selfproclaimengineer/legacy-2026/program lama/hexapod_robot_legacy/README.md

# program_hexapod_robot_legacy
Trajectory program, inverse kinematics, and body kinematics were developed in December 2023.

1. The leg program is a developmental program to move the robot.
2. The leg_trajectory_new program is a third-order trajectory program still in the development stage. For the future, the developed leg program will be the leg.ino program.
