selfproclaimengineer/legacy-2026/program lama/code_legacy_2024/CODE_LEGACY_2024/README.md

Mulai di upload tanggal 28 oktober 2024

=====28 Oktober=====
1. Robot sudah sampai bawah tangga
2. coxa femur tibia butuh di adjuts(sudah)
3. tinggi langkah sudah ok

======29 Oktober======
1. Bisa bawah tangga namun masih kadang error, butuh proteksi tambahan
2. settingan terbaru kaki bisa mulus lantai pecah , tapi masih bisa ditingkatkan
3. servo rusak saatnya pulang
