selfproclaimengineer/legacy-2026/program lama/hexapod_robot_legacy/master/readme

setup arduino
setup board
