selfproclaimengineer/legacy-2026/HEXAPOD_KRSRI_2026/config.h

#ifndef CONFIG_H
#define CONFIG_H

// =====================================================================
//  KONFIGURASI PUSAT HEXAPOD KRSRI 2026
//  Semua "knob" kalibrasi ada di sini. Ubah angka, JANGAN ubah logika.
//  Konvensi sumbu (body frame):
//     +X = kanan, +Y = depan, +Z = atas. Origin = pusat badan.
//  File ini murni konstanta (stdint saja) -> aman di-include host & Teensy.
// =====================================================================
#include <stdint.h>

#define NUM_SERVOS 18   // 6 kaki x 3 sendi (lengan terpisah, lihat ARM_*)

// ---------------------------------------------------------------------
//  DIMENSI KAKI (mm) -- ukur fisik robot Anda
// ---------------------------------------------------------------------
#define COXA_LENGTH   20.0f
#define FEMUR_LENGTH  80.0f
#define TIBIA_LENGTH  90.0f

// ---------------------------------------------------------------------
//  GEOMETRI BADAN
//  BODY_LEG_ORIGINS = posisi pangkal coxa tiap kaki relatif pusat (mm).
//  BODY_LEG_ANGLE   = arah hadap kaki (derajat, dari +X, CCW positif).
//                     Dipakai untuk transform titik kaki -> frame kaki
//                     supaya IK benar walau kaki terpasang menyudut.
//  Urutan kaki: 0=Ka-Depan 1=Ka-Tengah 2=Ka-Belakang
//               3=Ki-Belakang 4=Ki-Tengah 5=Ki-Depan
// ---------------------------------------------------------------------
const float BODY_LEG_ORIGINS[6][3] = {
    { 45.0f,  78.0f, 0.0f},  // 0
    { 90.0f,   0.0f, 0.0f},  // 1
    { 45.0f, -78.0f, 0.0f},  // 2
    {-45.0f, -78.0f, 0.0f},  // 3
    {-90.0f,   0.0f, 0.0f},  // 4
    {-45.0f,  78.0f, 0.0f}   // 5
};
const float BODY_LEG_ANGLE[6] = {
     60.0f,    // 0 Ka-Depan
      0.0f,    // 1 Ka-Tengah
    -60.0f,    // 2 Ka-Belakang
   -120.0f,    // 3 Ki-Belakang
    180.0f,    // 4 Ki-Tengah
    120.0f     // 5 Ki-Depan
};

// ---------------------------------------------------------------------
//  POSISI BERDIRI (HOME) ujung kaki, di frame badan (mm)
//  STAND_HEIGHT positif = tinggi badan dari tanah; foot z = -STAND_HEIGHT.
//  STAND_RADIUS = seberapa jauh kaki melebar dari origin coxa.
// ---------------------------------------------------------------------
#define STAND_HEIGHT  100.0f
#define STAND_RADIUS   70.0f   // jarak ujung kaki ke pangkal coxa (arah hadap kaki)

// ---------------------------------------------------------------------
//  PETA PIN SERVO KAKI  {driver_index(0/1), channel(0..15)}
//  driver 0 = PCA9685 @0x40, driver 1 = @0x41
// ---------------------------------------------------------------------
const uint8_t SERVO_PIN_MAP[NUM_SERVOS][2] = {
    {0, 8},  {0, 9},  {0, 10}, // Kaki 0 (coxa,femur,tibia)
    {0, 4},  {0, 5},  {0, 6},  // Kaki 1
    {0, 0},  {0, 1},  {0, 2},  // Kaki 2
    {1, 8},  {1, 9},  {1, 10}, // Kaki 3
    {1, 4},  {1, 5},  {1, 6},  // Kaki 4
    {1, 0},  {1, 1},  {1, 2}   // Kaki 5
};

// ---------------------------------------------------------------------
//  KALIBRASI SERVO
//  SERVO_PULSE_MIN/MAX = pulse (us) untuk 0 dan 180 derajat servo.
//  SERVO_INVERT  = balik arah putaran sendi.
//  SERVO_OFFSET  = derajat offset agar pose HOME = mekanik netral.
//                  ATUR per-servo saat kalibrasi (lihat README bag. Kalibrasi).
//  SERVO_TRIM_US = trim halus dalam mikrodetik (koreksi gear backlash).
// ---------------------------------------------------------------------
#define SERVO_PULSE_MIN  500
#define SERVO_PULSE_MAX  2500

const bool SERVO_INVERT[NUM_SERVOS] = {
    false, false, false,  // Kaki 0
    false, false, false,  // Kaki 1
    false, false, false,  // Kaki 2
    true,  true,  true,   // Kaki 3 (sisi kiri biasanya terbalik)
    true,  true,  true,   // Kaki 4
    true,  true,  true    // Kaki 5
};
const float SERVO_OFFSET[NUM_SERVOS] = {
    0,0,0,  0,0,0,  0,0,0,   // kanan
    0,0,0,  0,0,0,  0,0,0    // kiri  (isi saat kalibrasi)
};
const int16_t SERVO_TRIM_US[NUM_SERVOS] = {
    0,0,0,  0,0,0,  0,0,0,
    0,0,0,  0,0,0,  0,0,0
};

// ---------------------------------------------------------------------
//  GAIT (default = jalan datar). Profil medan diatur runtime via setProfile.
// ---------------------------------------------------------------------
#define GAIT_STEP_HEIGHT  40.0f    // mm, tinggi angkat kaki
#define GAIT_STEP_LENGTH  60.0f    // mm, panjang langkah penuh
#define GAIT_CYCLE_TIME   900.0f   // ms, 1 siklus penuh
#define GAIT_DUTY         0.5f     // fraksi waktu kaki menapak (tripod=0.5)

// ---------------------------------------------------------------------
//  LENGAN / GRIPPER (untuk ambil korban)
//  Default 3 servo pada driver 0 channel 12,13,14: base, shoulder, gripper.
//  Pose dalam derajat 0..180 (sudut servo). KALIBRASI sesuai mekanik.
// ---------------------------------------------------------------------
#define ARM_NUM_SERVOS 3
// Dua lengan: kanan di driver 0, kiri di driver 1 (base, shoulder, gripper).
const uint8_t ARM_PIN_MAP_R[ARM_NUM_SERVOS][2] = { {0, 12}, {0, 13}, {0, 14} };
const uint8_t ARM_PIN_MAP_L[ARM_NUM_SERVOS][2] = { {1, 12}, {1, 13}, {1, 14} };
// Pose: {base, shoulder, gripper}
const float ARM_POSE_PARK[ARM_NUM_SERVOS]  = { 90,  30,  20 };  // lipat aman
const float ARM_POSE_REACH[ARM_NUM_SERVOS] = { 90, 150,  70 };  // julur, capit buka
const float ARM_POSE_GRIP[ARM_NUM_SERVOS]  = { 90, 150,  10 };  // capit tutup
const float ARM_POSE_LIFT[ARM_NUM_SERVOS]  = { 90,  60,  10 };  // angkat korban
const float ARM_POSE_DROP[ARM_NUM_SERVOS]  = { 90, 120,  70 };  // taruh di safe zone

// ---------------------------------------------------------------------
//  BUS I2C — SATU jalur (sesuai PCB: 1x SDA/SCL untuk semua device).
//  Semua di Wire (SDA 18 / SCL 19 Teensy 4.1): 2x PCA9685 + mux + 6 VL53L1X.
//  Clock dibatasi 400 kHz karena VL53L1X & TCA9548A maksimum Fast Mode (400k);
//  walau PCA9685 bisa 1 MHz, di bus bersama clock ikut device terlambat.
//  (Pisah ke Wire1 untuk servo @1MHz HANYA bila PCB di-rework — lihat README.)
// ---------------------------------------------------------------------
#define SERVO_I2C_BUS    Wire
#define SERVO_I2C_CLOCK  400000
#define LIDAR_I2C_BUS    Wire
#define LIDAR_I2C_CLOCK  400000

// ---------------------------------------------------------------------
//  SENSOR
// ---------------------------------------------------------------------
#define NUM_LIDAR        6
#define I2C_MUX_ADDR     0x70
// Indeks lidar -> arti (sesuaikan pemasangan fisik)
#define LIDAR_FRONT      0
#define LIDAR_FRONT_R    1
#define LIDAR_RIGHT      2
#define LIDAR_BACK       3
#define LIDAR_LEFT       4
#define LIDAR_FRONT_L    5

#define IMU_SERIAL       Serial1
#define IMU_BAUD         921600   // Yahboom 10-axis (protokol WIT, frame 0x55)

// ---------------------------------------------------------------------
//  NAVIGASI (closed-loop)
// ---------------------------------------------------------------------
#define HEADING_KP        0.020f   // gain belok per derajat error heading
#define HEADING_TOL_DEG   3.0f     // toleransi heading dianggap "lurus"
#define WALL_SETPOINT_CM  13       // jarak target ke dinding (cm)
#define WALL_KP           0.030f   // gain koreksi wall-follow
#define FRONT_STOP_CM     20       // berhenti/belok bila depan < ini
#define NAV_FWD_SPEED     0.8f     // kecepatan maju normal (0..1)

// Arah mata angin (derajat kompas 0..360) -- kalibrasi di arena.
#define HEAD_UTARA    0.0f
#define HEAD_TIMUR   90.0f
#define HEAD_SELATAN 180.0f
#define HEAD_BARAT   270.0f

// ---------------------------------------------------------------------
//  PIN LAIN
// ---------------------------------------------------------------------
#define PIN_BUTTON_START  30   // tombol mulai (INPUT_PULLUP)
#define PIN_LED_FOUND     13   // LED tanda korban ditemukan (cek aturan lomba)

// Stabilisasi badan (IMU)
#define STAB_MAX_DEG      15.0f   // clamp koreksi roll/pitch
#define STAB_DEADBAND_DEG 1.0f    // abaikan getaran kecil
#define STAB_SMOOTH       0.20f   // 0..1, makin kecil makin halus

#endif
