selfproclaimengineer/legacy-2026/(commit log)

2026-06-21 Hexapod KRSRI: firmware refaktor + vision Pi5 + analisis legacy
    - HEXAPOD_KRSRI_2026: refaktor firmware Teensy 4.1 (gait+yaw, IK teruji,
    lidar non-blocking, HexaArm gripper, navigasi closed-loop, FSM misi)
    - RASPI_VISION_KRSRI: README deteksi korban YOLOv8n->ONNX + protokol UART
    - program lama: arsip 4 generasi kode + ANALISIS.md
2026-06-21 Firmware: IMU Yahboom 10-axis + 2 lengan + I2C 1-bus; berkas lomba
    Firmware (HEXAPOD_KRSRI_2026):
    - IMU Yahboom 10-axis (protokol WIT 0x55): baud 921600 + validasi checksum
    - Dukungan 2 lengan penyelamat (kanan/kiri) di PCA9685 0x40/0x41
    - I2C 1 jalur @400kHz sesuai PCB (knob pisah-bus tetap ada di config)
    Berkas lomba (berkas_lomba):
    - ANALISIS_BERKAS, PROPOSAL_DRAFT, draf isi borang (md + docx)
